aculleon/HVI/HVI.kicad_sch

## KiCad design HVI.kicad_sch (2026-02-08)

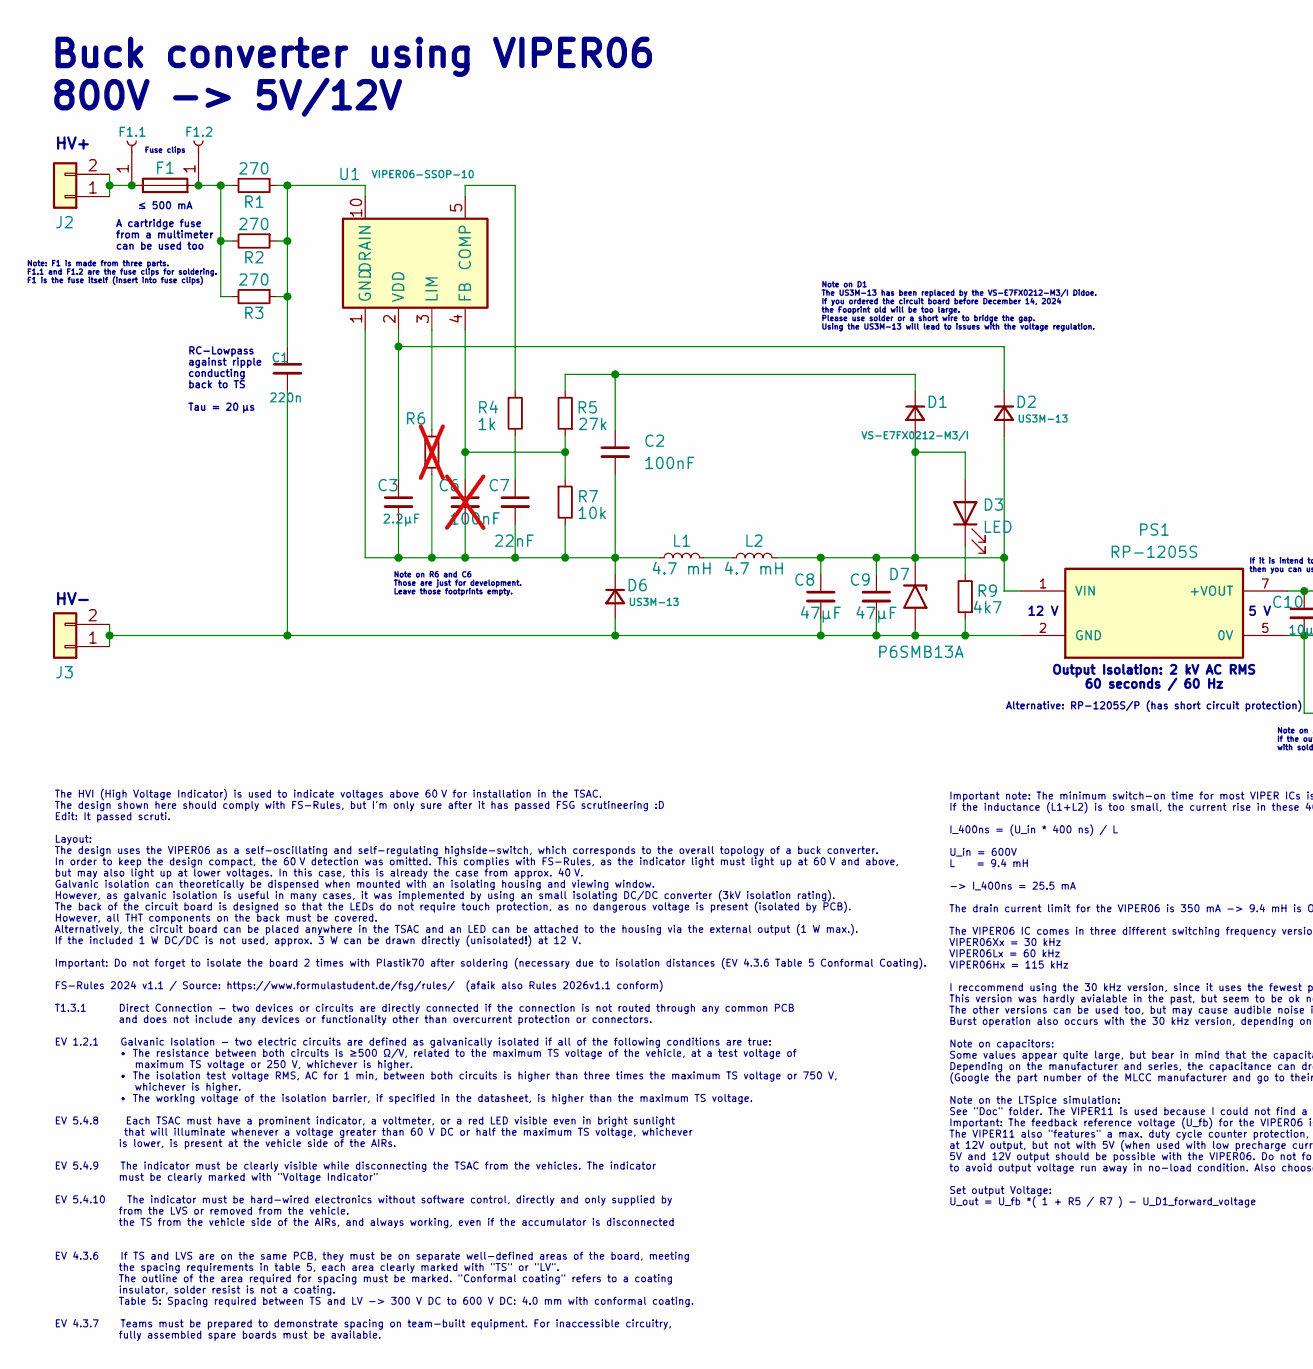
[picture p1: schematic HVI.kicad_sch, part in row 1, column 1]

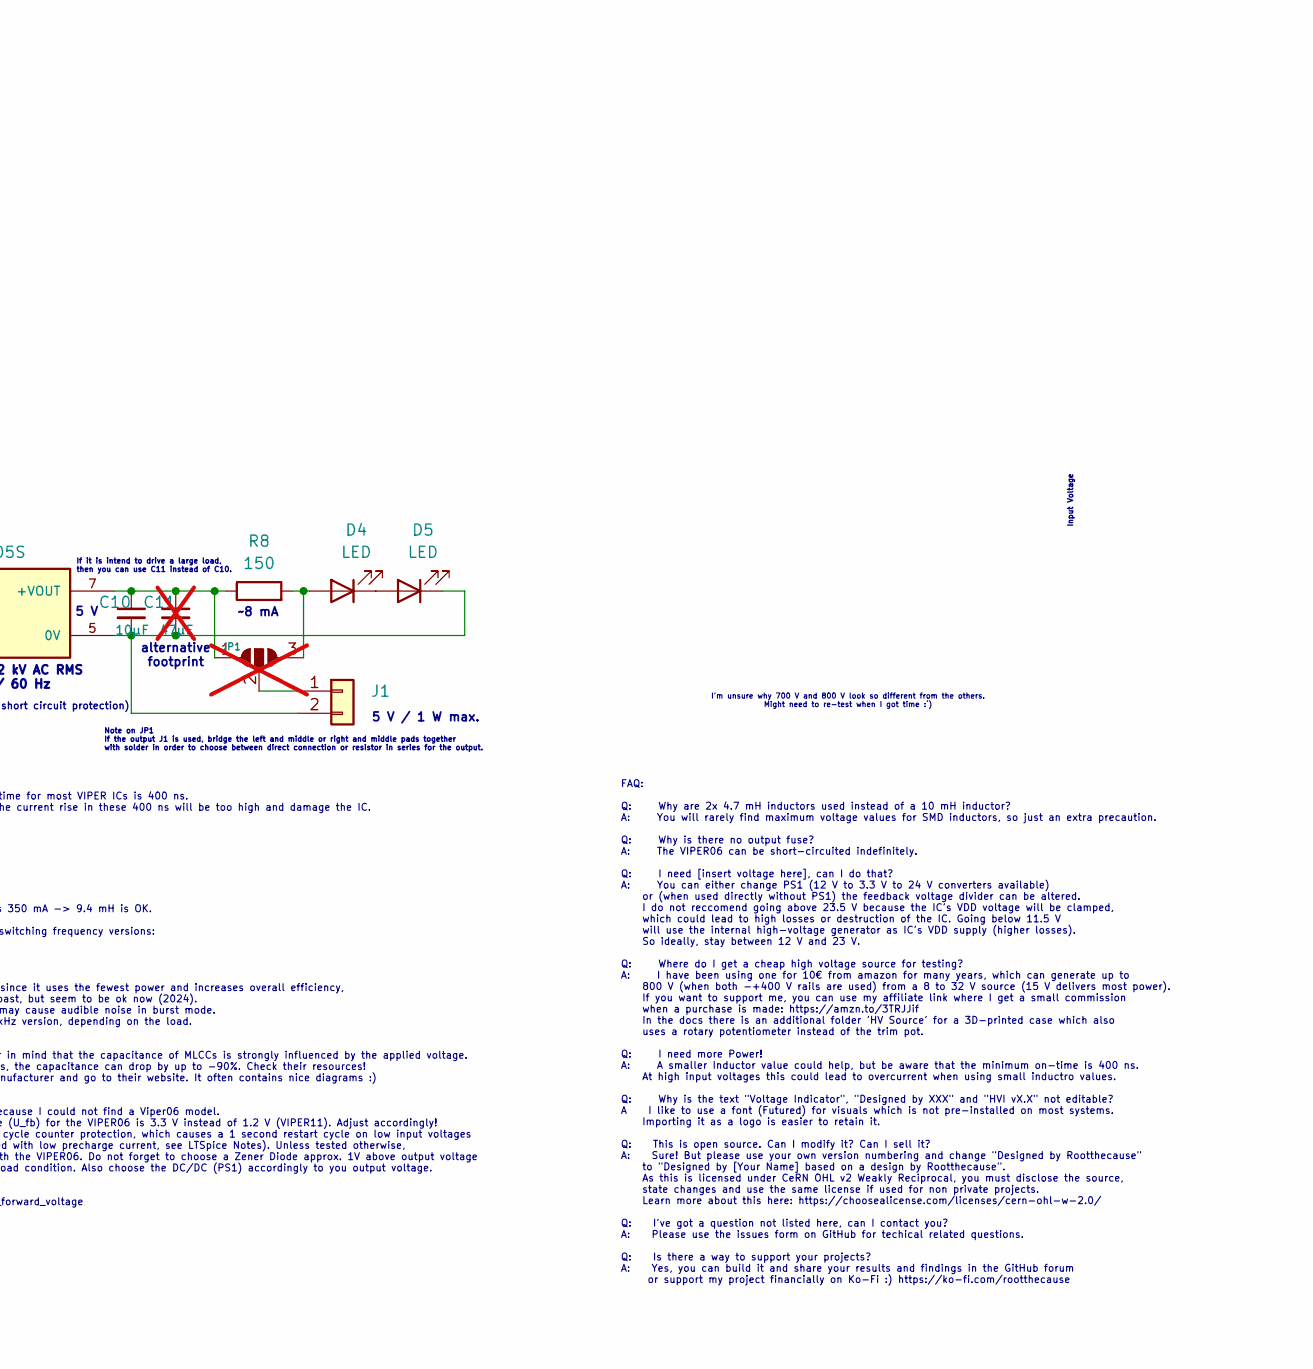
[picture p2: schematic HVI.kicad_sch, part in row 1, column 2]

Parts:
C1: 220n; C_2220_5650Metric; Mouser 810-C5750X7R2J224K
C2: 100nF; C_0603_1608Metric_Pad1.08x0.95mm_HandSolder; Mouser 81-GRM188R72A103MA1J
C3: 2.2µF; C_0603_1608Metric_Pad1.08x0.95mm_HandSolder; Mouser 963-UMK107BBJ225KA-T
C6: 100nF; C_0603_1608Metric_Pad1.08x0.95mm_HandSolder; not fitted
C7: 22nF; C_0603_1608Metric_Pad1.08x0.95mm_HandSolder; Mouser 80-C0603C223J3RAUTO
C8, C9: 47µF; C_1210_3225Metric_Pad1.33x2.70mm_HandSolder; Mouser 963-E32MAB5476MPNDTJ
C10: 10µF; C_0603_1608Metric_Pad1.08x0.95mm_HandSolder; Mouser 81-GRM188R6YA106MA3J
C11: 47µF; C_1210_3225Metric_Pad1.33x2.70mm_HandSolder; not fitted
D1: VS-E7FX0212-M3/I; D_SMF; Mouser 78-VS-E7FX0212-M3/I
D2, D6: US3M-13; D_SMC; Mouser 621-US3M-13
D3, D4, D5: LED; LED_0603_1608Metric_Pad1.05x0.95mm_HandSolder; Mouser 604-APTD1608LSURCK
D7: P6SMB13A; D_SMB; Mouser 652-P6SMB13A
F1: ≤ 500 mA, solder Fuse Clips F1.1 and F1.2 and ins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; Fuseholder0,25Zoll_32mm_littlefuse_102_122; Mouser 530-0ADAC0250-BE
F1.1, F1.2: Fuse Clips; -; Mouser 576-01220083Z
J1, J2, J3: Conn_01x02; Molex_Micro-Fit_3.0_43650-0215_1x02_P3.00mm_Vertical; Mouser 538-43650-0215
JP1: SolderJumper_3_Open; SolderJumper-3_P1.3mm_Open_RoundedPad1.0x1.5mm_NumberLabels; not fitted
L1, L2: 4.7 mH; L_Bourns_SRR1208_12.7x12.7mm; Mouser 652-SRR1208-472KL
PS1: RP-1205S; CONV_PEME1-S5-S5-S; LCSC X
R1, R2, R3: 270; R_1206_3216Metric_Pad1.30x1.75mm_HandSolder; Mouser 755-KTR18EZPF2700
R4: 1k; R_0603_1608Metric_Pad0.98x0.95mm_HandSolder; Mouser 71-CRCW06031K00FKEE
R5: 27k; R_0603_1608Metric_Pad0.98x0.95mm_HandSolder; Mouser 603-AC0603FR-0727KL
R6: -; R_0603_1608Metric_Pad0.98x0.95mm_HandSolder; not fitted
R7: 10k; R_0603_1608Metric_Pad0.98x0.95mm_HandSolder; Mouser 603-AC0603JR-0710KL
R8: 150; R_0603_1608Metric_Pad0.98x0.95mm_HandSolder; Mouser 603-AC0603FR-10150RL
R9: 4k7; R_0603_1608Metric_Pad0.98x0.95mm_HandSolder; Mouser 603-RC0201FR-074K7L
U1: VIPER06-SSOP-10; SSOP-10_3.9x4.9mm_P1.00mm; Mouser 511-VIPER06XSTR

Connections:
unnamed: C1.1, R1.1, R2.1, R3.1, U1.6 (DRAIN), U1.7 (DRAIN), U1.8 (DRAIN), U1.9 (DRAIN), U1.10 (DRAIN)
unnamed: C1.2, C8.2, C9.2, D6.2 (A), D7.2 (A2), J3.1, J3.2, PS1.2 (GND), R9.1
unnamed: C2.1, D1.1 (K), R5.2
unnamed: C2.2, C3.2, C6.2, C7.2, D6.1 (K), L1.1, R6.2, R7.2, U1.1 (GND)
unnamed: C3.1, D2.1 (K), U1.2 (VDD)
unnamed: C6.1, R5.1, R7.1, U1.4 (FB)
unnamed: C7.1, R4.2
unnamed: C8.1, C9.1, D1.2 (A), D2.2 (A), D3.2 (A), D7.1 (A1), L2.2, PS1.1 (VIN)
unnamed: C10.1, C11.1, JP1.1 (A), PS1.7 (+VOUT), R8.1
unnamed: C10.2, C11.2, D5.1 (K), J1.2, PS1.5 (0V)
unnamed: D3.1 (K), R9.2
unnamed: D4.1 (K), D5.2 (A)
unnamed: D4.2 (A), JP1.3 (B), R8.2
unnamed: F1.1, F1.1.1, J2.1, J2.2
unnamed: F1.2, F1.2.1, R1.2, R2.2, R3.2
unnamed: J1.1, JP1.2 (C)
unnamed: L1.2, L2.1
unnamed: R4.1, U1.5 (COMP)
unnamed: R6.1, U1.3 (LIM)

Notes on the sheet:
If it is intend to drive a large load, then you can use C11 instead of C10.
I'm unsure why 700 V and 800 V look so different from the others. Might need to re-test when I got time :‘)
Buck converter using VIPER06 800V -> 5V/12V
FAQ: Q: Why are 2x 4.7 mH inductors used instead of a 10 mH inductor? A: You will rarely find maximum voltage values for SMD inductors, so just an extra precaution. Q: Why is there no output fuse? A: The VIPER06 can be short-circuited indefinitely. Q: I need [insert voltage here], can I do that? A: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
HV-
Alternative: RP-1205S/P (has short circuit protection)
5 V / 1 W max.
The HVI (High Voltage Indicator) is used to indicate voltages above 60 V for installation in the TSAC. The design shown here should comply with FS-Rules, but I'm only sure after it has passed FSG scrutineering :D Edit: It passed scruti. Layout: The design uses the VIPER06 as a self-oscillating and 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
Input Voltage
≤ 500 mA
Output Isolation: 2 kV AC RMS 60 seconds / 60 Hz
5 V
Note on R6 and C6 Those are just for development. Leave those footprints empty.
RC-Lowpass against ripple conducting back to TS Tau = 20 µs
~8 mA
Note: F1 is made from three parts. F1.1 and F1.2 are the fuse clips for soldering. F1 is the fuse itself (insert into fuse clips)
12 V
alternative footprint
Note on JP1 If the output J1 is used, bridge the left and middle or right and middle pads together with solder in order to choose between direct connection or resistor in series for the output.
Fuse clips
A cartridge fuse from a multimeter can be used too
Important note: The minimum switch-on time for most VIPER ICs is 400 ns. If the inductance (L1+L2) is too small, the current rise in these 400 ns will be too high and damage the IC. I_400ns = (U_in * 400 ns) / L U_in = 600V L = 9.4 mH -> I_400ns = 25.5 mA The drain current limit for the VIPER06 is 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
HV+
Note on D1 The US3M-13 has been replaced by the VS-E7FX0212-M3/I Didoe. If you ordered the circuit board before December 14, 2024 the Fooprint old will be too large. Please use solder or a short wire to bridge the gap. Using the US3M-13 will lead to issues with the voltage regulation.
